mirauta-alexandru/IRIS-vision-robot-arm/files/aruco_4x4_50_markers_30mm_A4.pdf

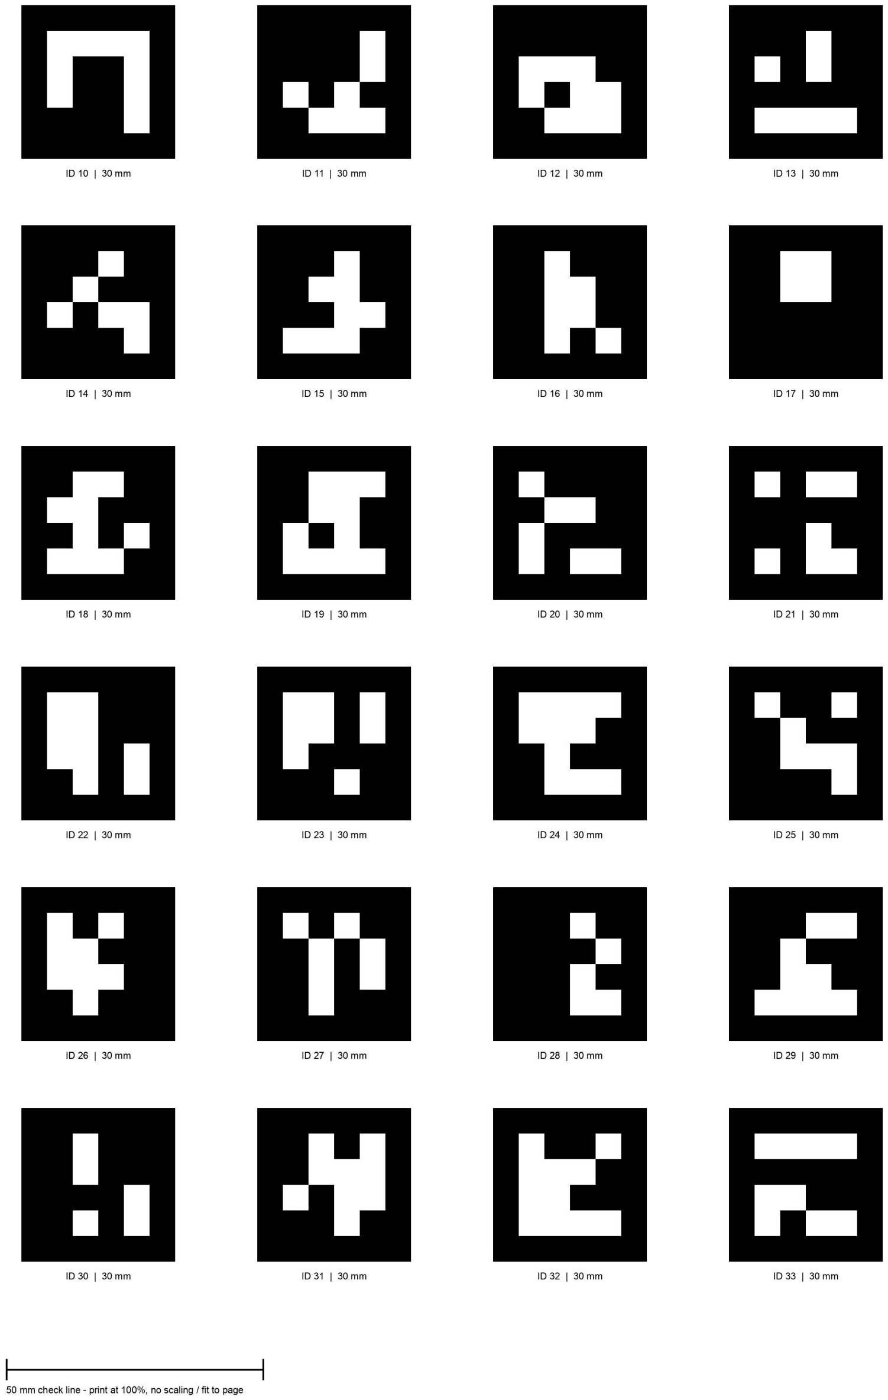
[picture p3: page 1]
