mirauta-alexandru/IRIS-vision-robot-arm/assets/github-open-graph.png

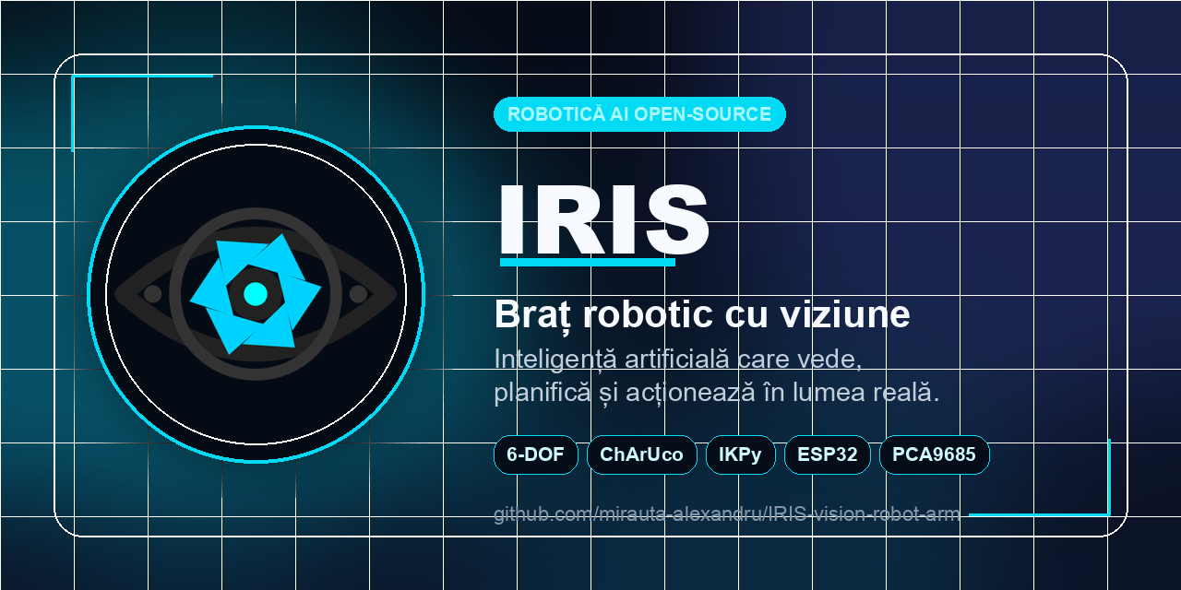
assets/github-open-graph.png
