mirauta-alexandru/IRIS-vision-robot-arm/(commit log)

2026-05-17 Initial open-source IRIS robot arm release
    [hp_psu_enclosure.scad, iris_arm.urdf]
2026-05-17 Clean up legacy root files
    [hp_psu_enclosure.scad]
